orlandod543/PiezoSaurus/Simulations/Piezo_amplifierV2.0.asc

C1: cap; 22n
D1: diode; RF01VM2S
R1: res; 10k
R2: res; 47k
R3: res; 10k
R4: res; 10k
R5: res; 10k
R6: res; 8k
R7: res; 10k
U1: lmv324
U2: lmv324
U3: lmv324
U4: lmv324
V1: voltage; 3.3
V2: voltage; PULSE(-0 0.4 1m 100u 100u 1m 10m 100); AC 0.1
Named nets: 0, 3.3V, Vref, vin
.tran 100m startup
;ac dec 100 100m 1meg
