orlandod543/PiezoSaurus/piezo_amplifier/piezo_amplifier.kicad_pcb

## KiCad design piezo_amplifier/piezo_amplifier.kicad_pcb (2020-04-12)

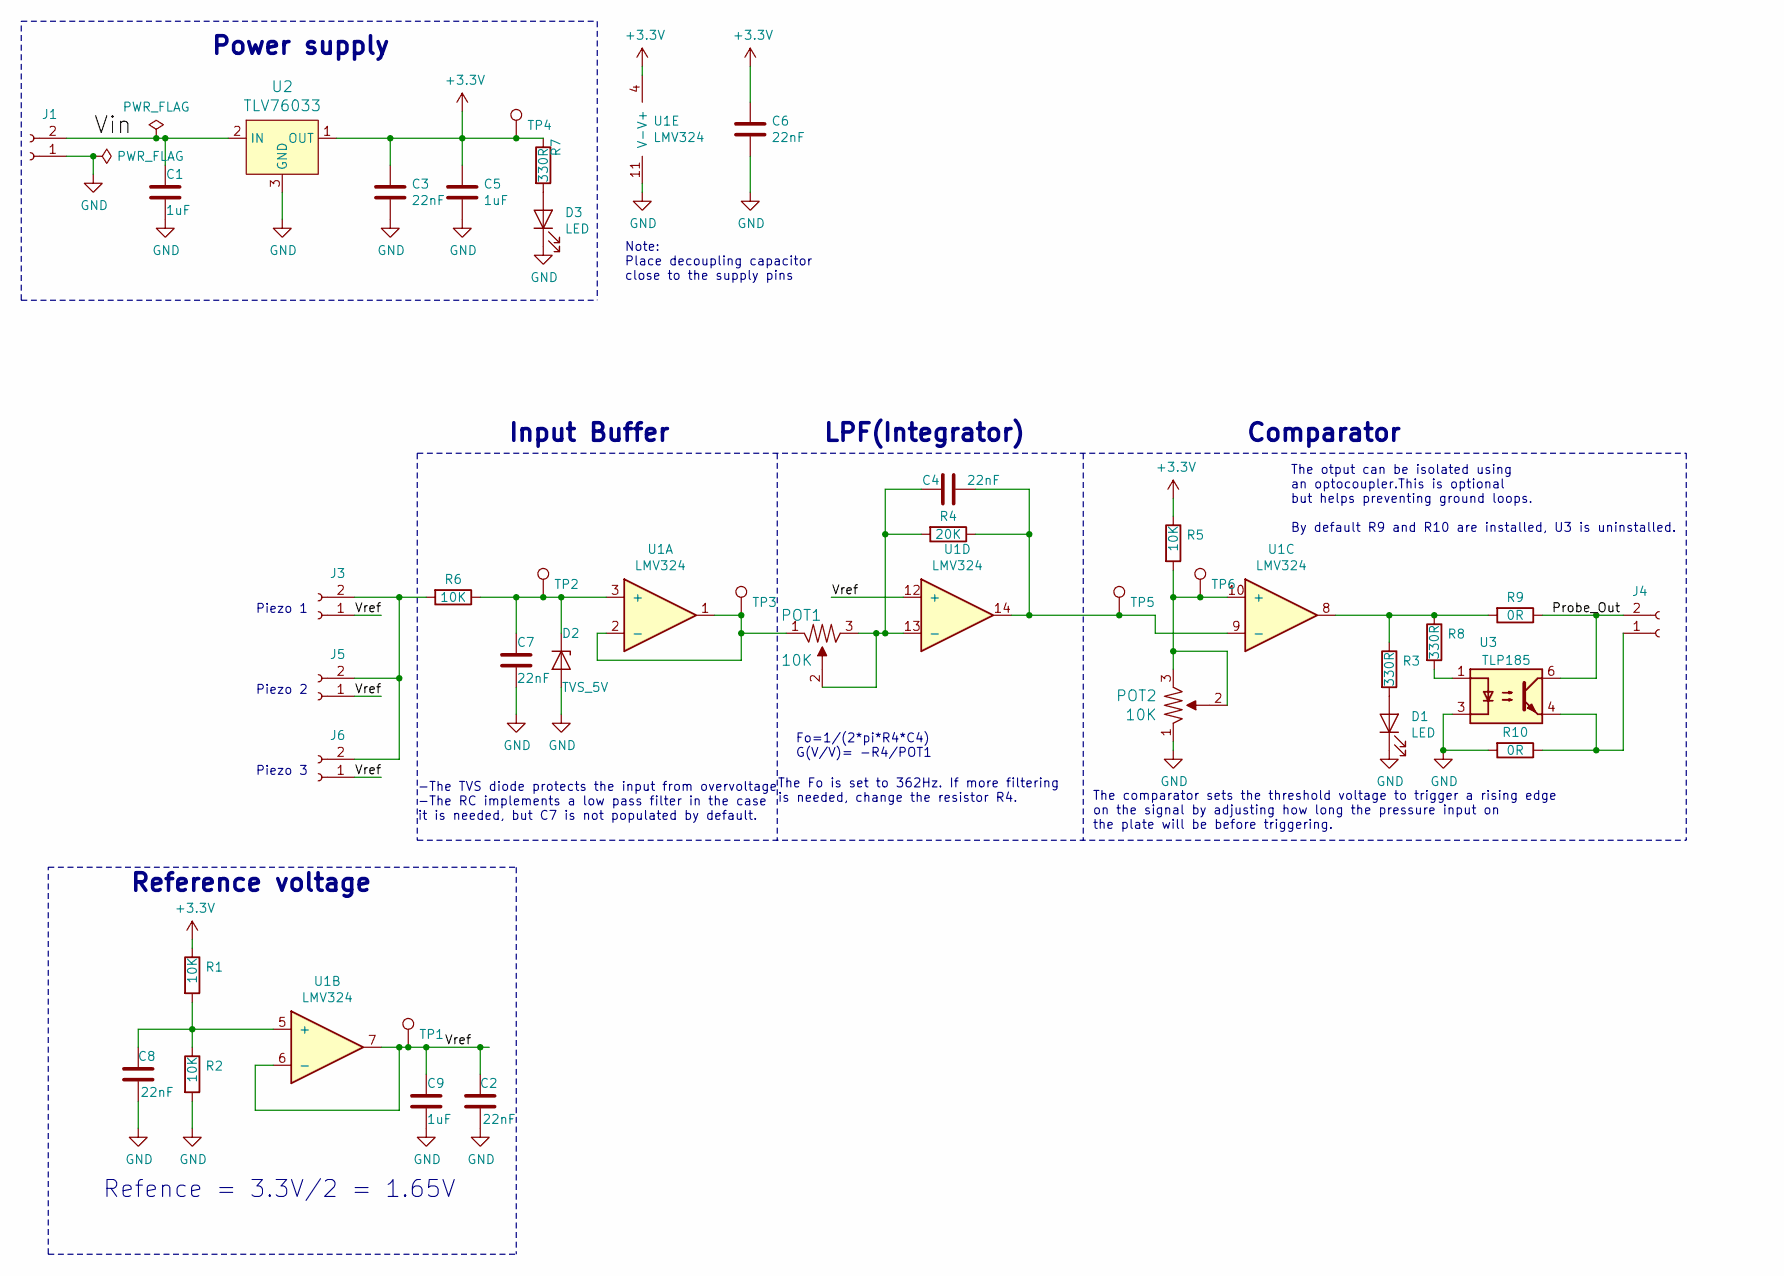
[picture p1: schematic piezo_amplifier.sch, PiezoSaurus Piezo amplifier]

Parts:
C1, C5, C9: 1uF; C_0603_1608Metric_Pad1.05x0.95mm_HandSolder; MPN C1608X7R1V105K080AC
C2, C3, C4, C6, C7, C8: 22nF; C_0603_1608Metric_Pad1.05x0.95mm_HandSolder; MPN CGA3E2X7R1H223K080AA
D1: LED; LED_0603_1608Metric
D2: TVS_5V; D_SOD-123; MPN SMF5.0A
D3: LED; LED_0603_1608Metric; MPN 150060VS75000
J1, J3, J4, J5, J6: S2B-XH-A-1; JST_XH_S2B-XH-A_1x02_P2.50mm_Horizontal; MPN S2B-XH-A_(LF)(SN)
POT1, POT2: 10K; Trimpot_3.8mmx3.6mm_TC33X-2-103E; MPN TC33X-2-103E; Digi-Key_PN TC33X-103ETR-ND
R1, R2, R5, R6: 10K; R_0603_1608Metric
R3, R7, R8: 330R; R_0603_1608Metric
R4: 20K; R_0603_1608Metric
R9, R10: 0R; R_0603_1608Metric
TP1, TP2, TP3, TP4, TP5, TP6: TestPoint; TestPoint_Loop_D1.80mm_Drill1.0mm_Beaded
U1: LMV324; SOIC-14_3.9x8.7mm_P1.27mm; MPN LMV324IDR
U2: TLV76033; SOT-23; MPN TLV76033DBZT; Digi-Key_PN 296-47016-1-ND
U3: TLP185; SOIC-4_4.55x3.7mm_P2.54mm; MPN TLP185(GR,E(O

Connections:
+3V3: C3.1, C5.1, C6.1, R1.1, R5.1, R7.1, TP4.1, U1.4 (V+), U2.1 (OUT)
/Probe_Out: J4.2, R9.1, U3.6
/Vin: C1.1, J1.2, U2.2 (IN)
/Vref: C2.2, C9.1, J3.1, J5.1, J6.1, TP1.1, U1.6 (-), U1.7, U1.12 (+)
GND: C1.2, C2.1, C3.2, C5.2, C6.2, C7.2, C8.1, C9.2, D1.1 (K), D2.2 (A), D3.1 (K), J1.1, POT2.1 (CCW), R2.2, R10.2, U1.11 (V-), U2.3 (GND), U3.3
unnamed: C4.1, R4.1, TP5.1, U1.9 (-), U1.14
unnamed: C4.2, POT1.2 (Wiper), POT1.3 (CW), R4.2, U1.13 (-)
unnamed: C7.1, D2.1 (K), R6.1, TP2.1, U1.3 (+)
unnamed: C8.2, R1.2, R2.1, U1.5 (+)
unnamed: D1.2 (A), R3.2
unnamed: D3.2 (A), R7.2
unnamed: J3.2, J5.2, J6.2, R6.2
unnamed: J4.1, R10.1, U3.4
unnamed: POT1.1 (CCW), TP3.1, U1.1, U1.2 (-)
unnamed: POT2.2 (Wiper), POT2.3 (CW), R5.2, TP6.1, U1.10 (+)
unnamed: R3.1, R8.1, R9.2, U1.8
unnamed: R8.2, U3.1

Notes on the sheet:
Power supply
Note: Place decoupling capacitor close to the supply pins
Refence = 3.3V/2 = 1.65V
Reference voltage
Input Buffer
-The TVS diode protects the input from overvoltage -The RC implements a low pass filter in the case it is needed, but C7 is not populated by default.
Fo=1/(2*pi*R4*C4) G(V/V)= -R4/POT1
The Fo is set to 362Hz. If more filtering is needed, change the resistor R4.
LPF(Integrator)
The comparator sets the threshold voltage to trigger a rising edge on the signal by adjusting how long the pressure input on the plate will be before triggering.
Comparator
Piezo 1
Piezo 2
Piezo 3
The otput can be isolated using an optocoupler.This is optional but helps preventing ground loops. By default R9 and R10 are installed, U3 is uninstalled.

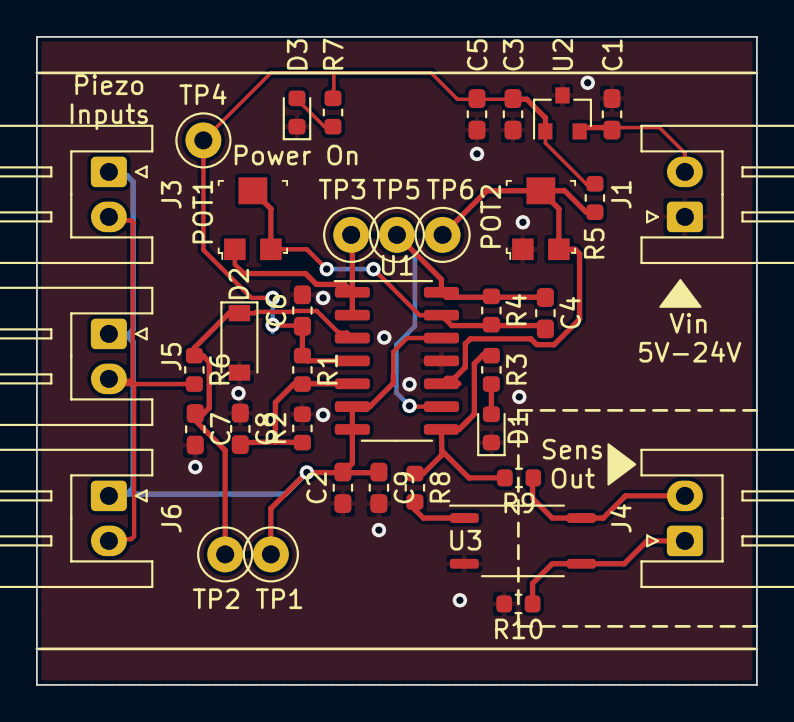
[picture p2: board piezo_amplifier.kicad_pcb from above]

Board: 2 copper layers, 40.0 x 36.0 mm, 38 parts (0 on the bottom side), 17 nets.
