orlandod543/PiezoSaurus/(commit log)

2019-04-27 PiezoSaurus v1.0 released. Production files generated. Ready for testing:
    [piezo_amplifier-B.Cu.gbr, piezo_amplifier-B.Mask.gbr, piezo_amplifier-B.Paste.gbr, piezo_amplifier-B.SilkS.gbr, piezo_amplifier-Edge.Cuts.gbr, piezo_amplifier-F.Cu.gbr, piezo_amplifier-F.Mask.gbr, piezo_amplifier-F.Paste.gbr]
2019-04-28 Add logo and minor silkscreen fixes
    [piezo_amplifier.kicad_pcb]
2019-04-28 Add Logo on silkscreen
    [piezo_amplifier.kicad_pcb]
2020-02-27 Schematic for V2.0 done
2020-04-11 PCB and schematics files finished, ready for release.
    [piezo_amplifier.kicad_pcb, piezo_amplifier.sch]
2020-04-12 Version V2.0 released
    [piezo_amplifier-B.Cu.gbr, piezo_amplifier-B.Mask.gbr, piezo_amplifier-B.Paste.gbr, piezo_amplifier-B.SilkS.gbr, piezo_amplifier-Edge.Cuts.gbr, piezo_amplifier-F.Cu.gbr, piezo_amplifier-F.Mask.gbr, piezo_amplifier-F.Paste.gbr]
2020-04-12 Piezo amplifier V2.0 released. Updated with the new library convention to show not installed components and standardizing fields.
    [piezo_amplifier-B_Cu.gbr, piezo_amplifier-B_Mask.gbr, piezo_amplifier-B_Paste.gbr, piezo_amplifier-B_SilkS.gbr, piezo_amplifier-Edge_Cuts.gbr, piezo_amplifier-F_Cu.gbr, piezo_amplifier-F_Mask.gbr, piezo_amplifier-F_Paste.gbr]
2020-04-12 fixup! Piezo amplifier V2.0 released. Updated with the new library convention to show not installed components and standardizing fields.
    [piezo_amplifier-top-pos_jlcpcb.csv, piezo_amplifier.kicad_pcb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]
2020-04-13 fixup! fixup! Piezo amplifier V2.0 released. Updated with the new library convention to show not installed components and standardizing fields.
    [piezo_amplifier-B_Cu.gbr, piezo_amplifier-B_Mask.gbr, piezo_amplifier-B_Paste.gbr, piezo_amplifier-B_SilkS.gbr, piezo_amplifier-Edge_Cuts.gbr, piezo_amplifier-F_Cu.gbr, piezo_amplifier-F_Mask.gbr, piezo_amplifier-F_Paste.gbr]
